oxtknight/ARTv9G1/schematics/protoboard.jpg

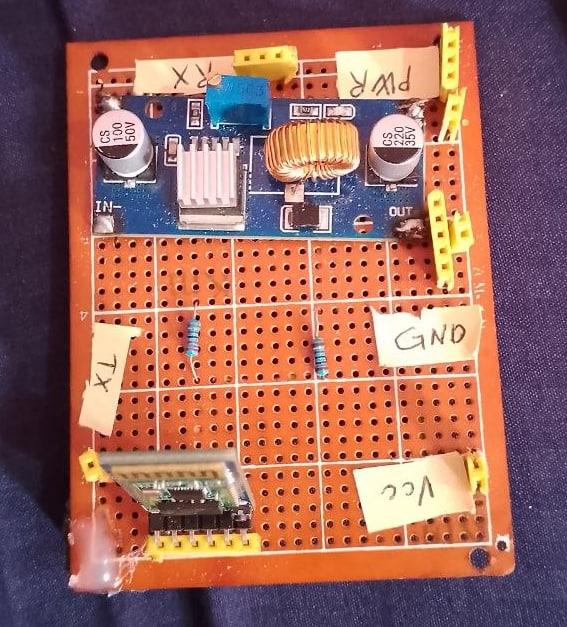
schematics/protoboard.jpg
