oxtknight/ARTv9G1/vids&pics/armbase&shoulder2.jpg

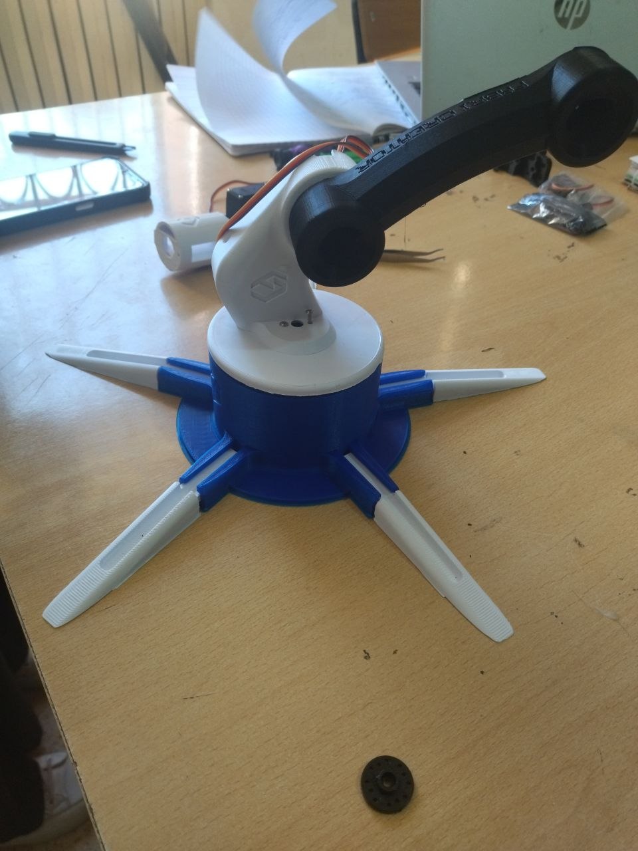
vids&pics/armbase&shoulder2.jpg
