oxtknight/ARTv9G1/schematics/note.txt

about the schematic:
Chaima said: "That's the schematic, remember that I did not find a HC05 so I used rgb"
