oxtknight/ARTv9G1/app/app_readme.md

### Some things to note:

- You can open the .aia file directly using MIT app editor or Kodular in order to make changes yourself
- You may as well install the .apk file for direct use

that's it. thank you!!
