oxtknight/ARTv9G1/app/logic blocks/arm position reset.jpg

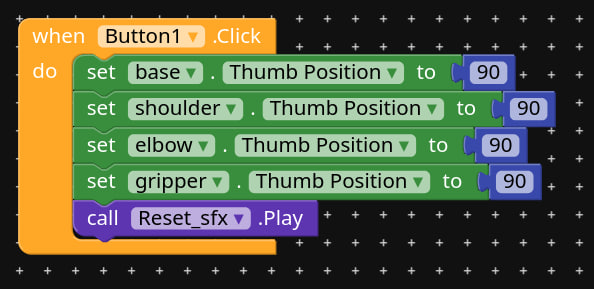
app/logic blocks/arm position reset.jpg
