oxtknight/ARTv9G1/app/logic blocks/bluetooth connection.jpg

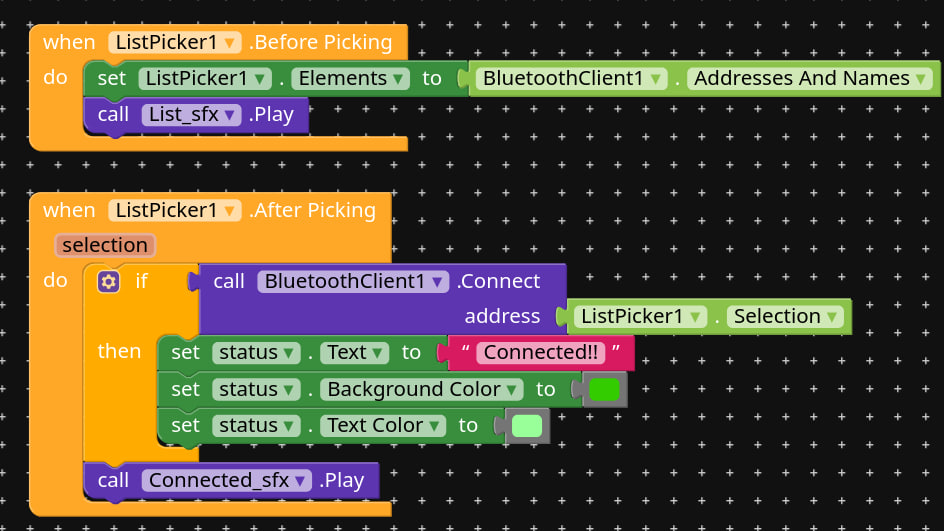
app/logic blocks/bluetooth connection.jpg
