oxtknight/ARTv9G1/app/logic blocks/inverse kin cooridinates.jpg

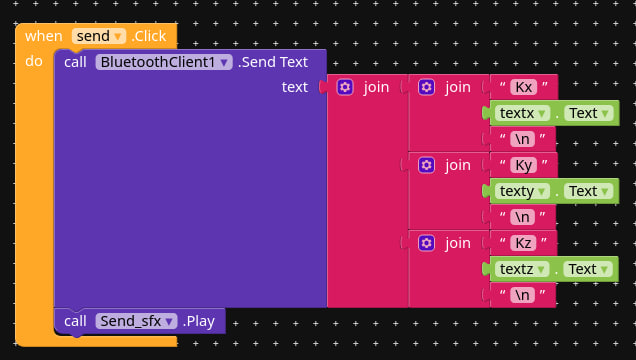
app/logic blocks/inverse kin cooridinates.jpg
