oxtknight/ARTv9G1/app/logic blocks/position_buttons.png

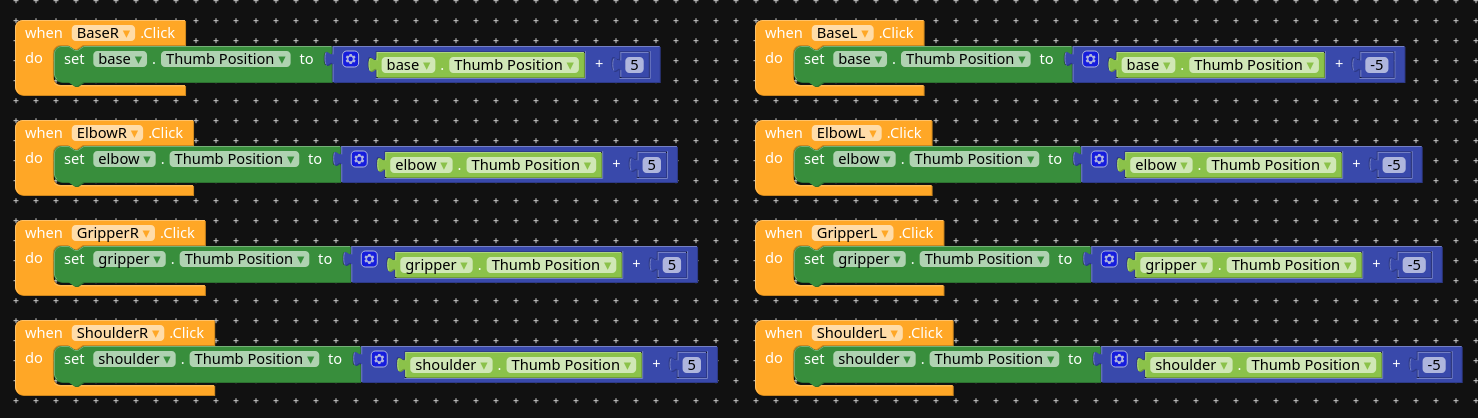
app/logic blocks/position_buttons.png
