oxtknight/ARTv9G1/app/logic blocks/position_sliders.jpg

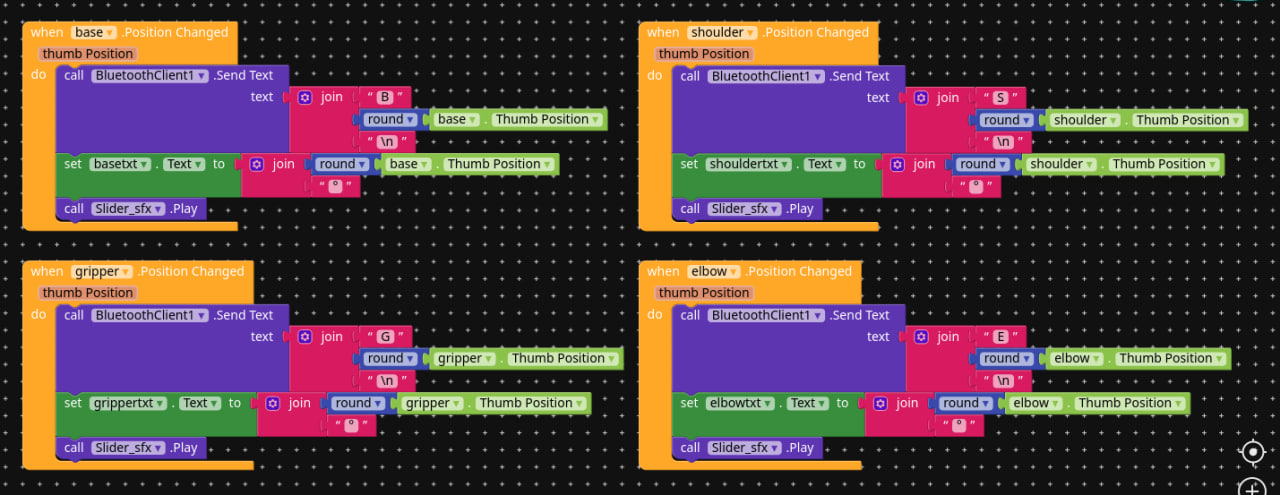
app/logic blocks/position_sliders.jpg
