oxtknight/ARTv9G1/app/User Interface.jpg

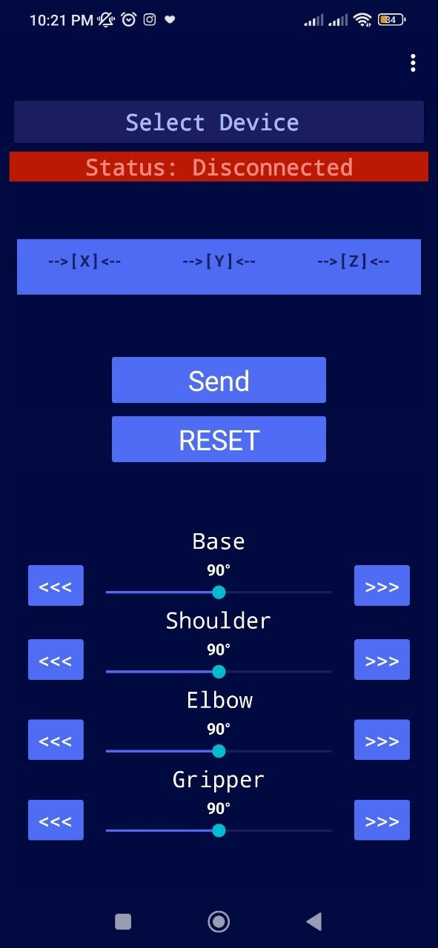
app/User Interface.jpg
