oxtknight/ARTv9G1/schematics/Screenshot from 2026-06-11 14-52-59.png

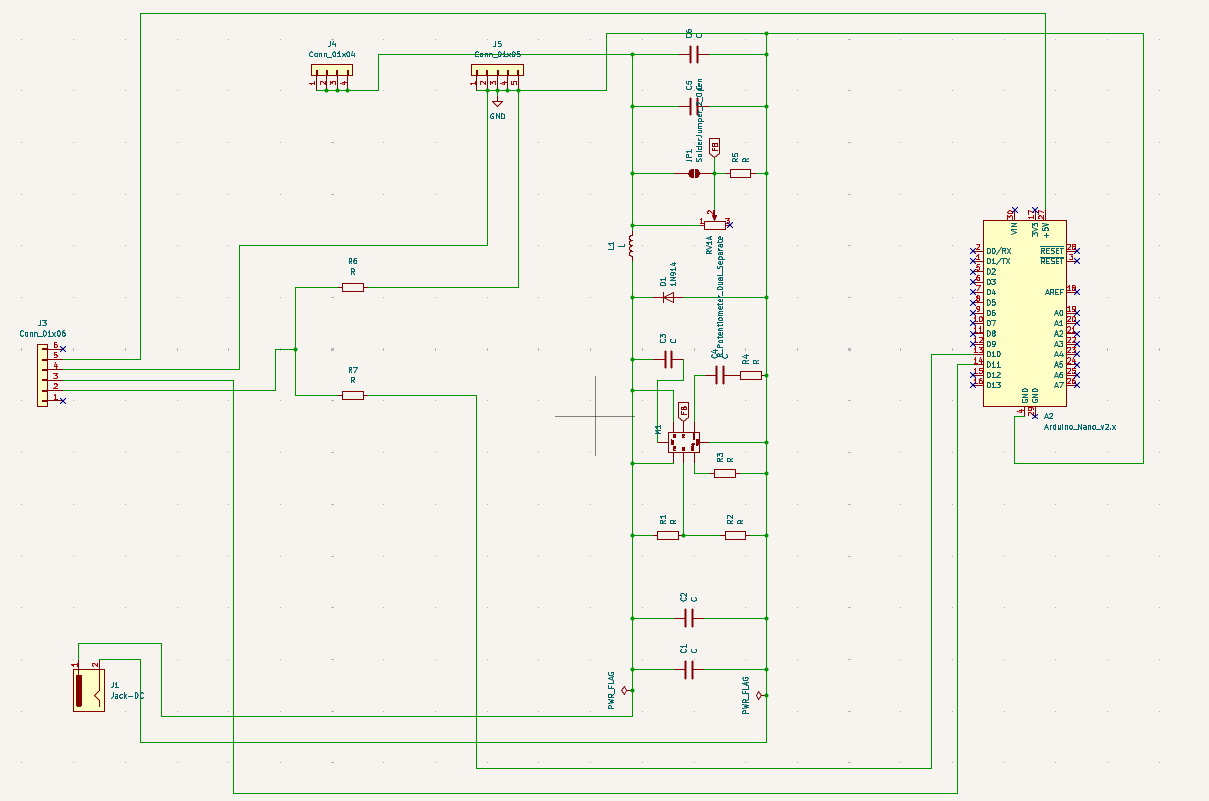
schematics/Screenshot from 2026-06-11 14-52-59.png
