oxtknight/ARTv9G1/vids&pics/aestethibasec.jpg

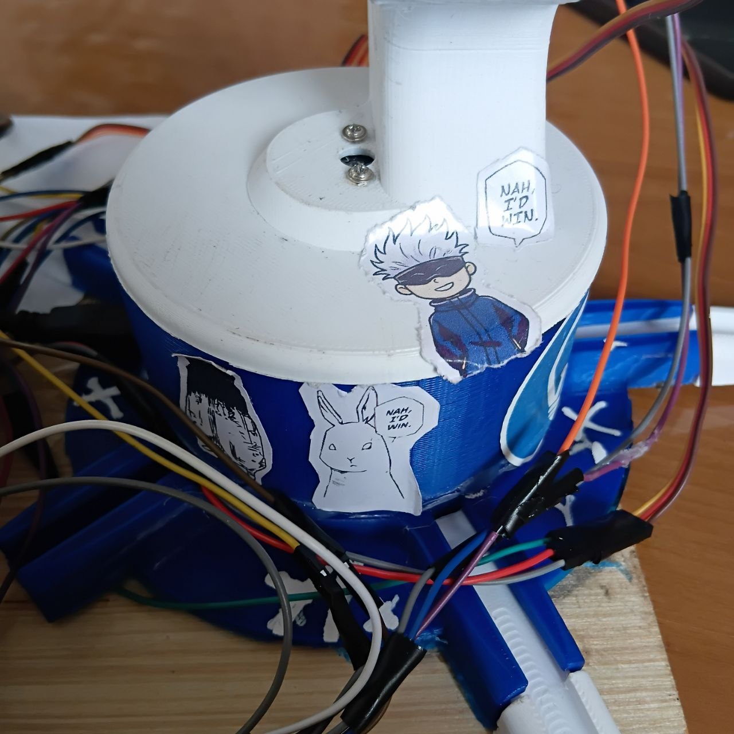
vids&pics/aestethibasec.jpg
