oxtknight/ARTv9G1/vids&pics/armbase&shoulder3.jpg

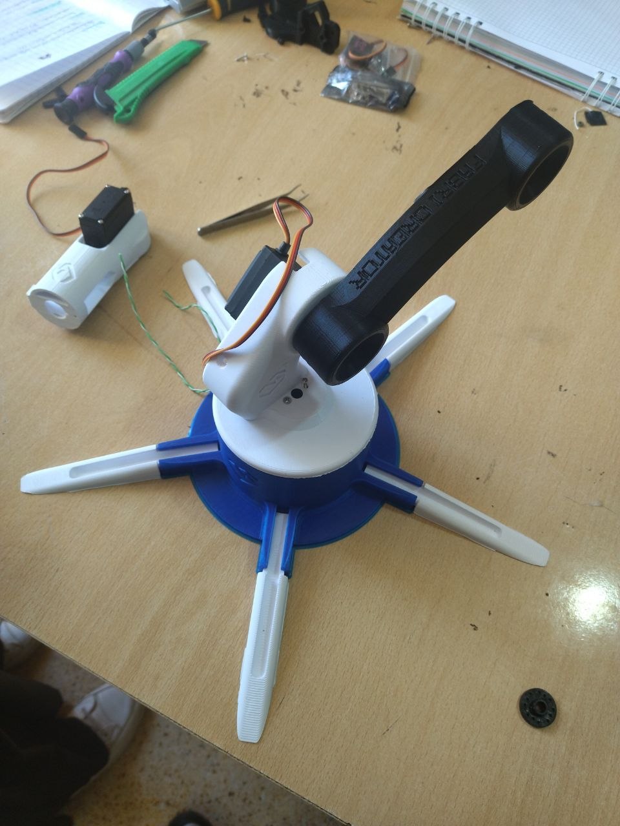
vids&pics/armbase&shoulder3.jpg
