oxtknight/ARTv9G1/vids&pics/armbase&shoulder.jpg

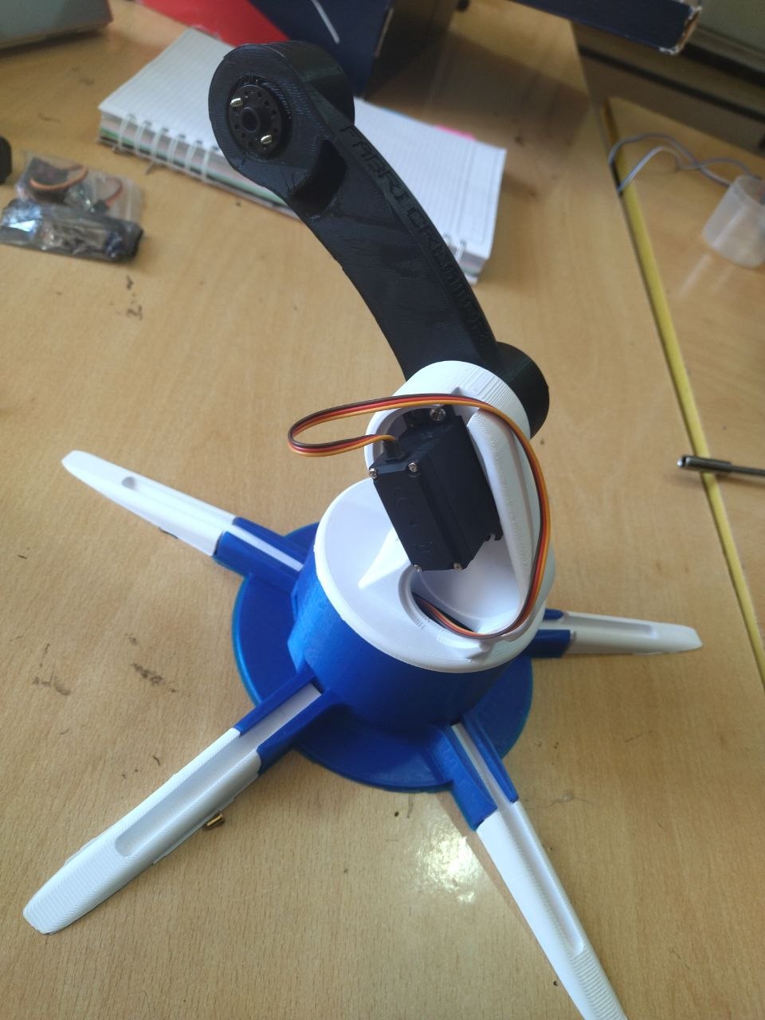
vids&pics/armbase&shoulder.jpg
