oxtknight/ARTv9G1/vids&pics/armdetached.jpg

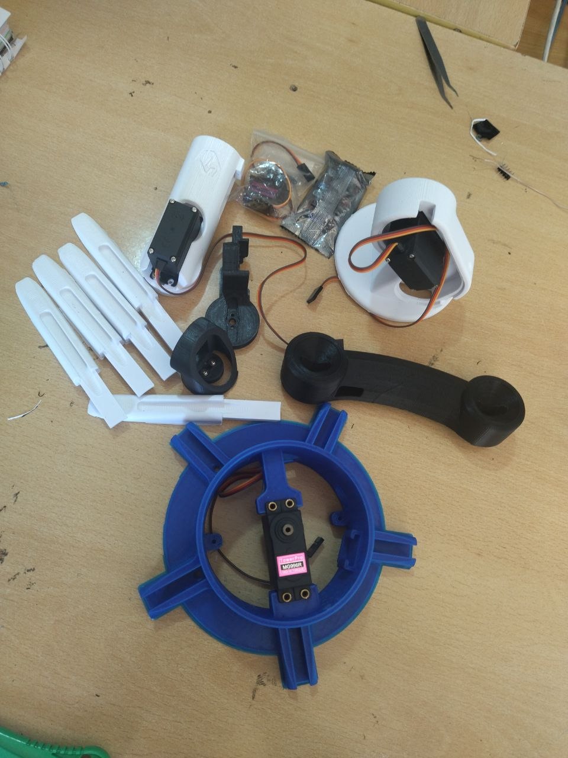
vids&pics/armdetached.jpg
