oxtknight/ARTv9G1/vids&pics/armfirstuild.jpg

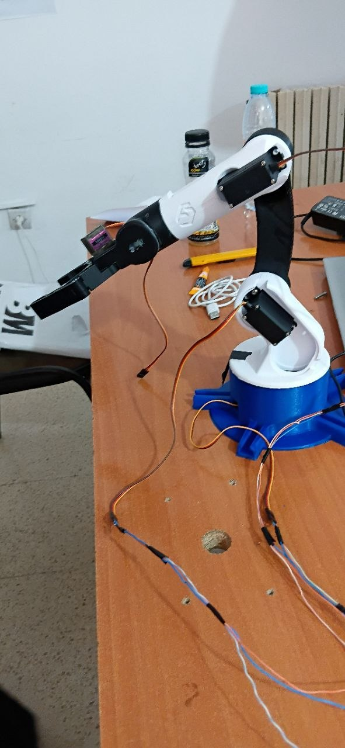
vids&pics/armfirstuild.jpg
