oxtknight/ARTv9G1/vids&pics/armrest.jpg

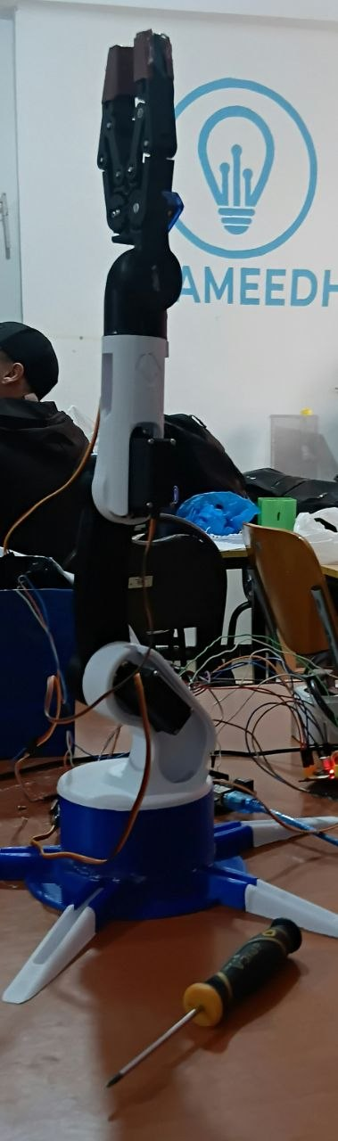
vids&pics/armrest.jpg
