oxtknight/ARTv9G1/vids&pics/hc05breadboard.jpg

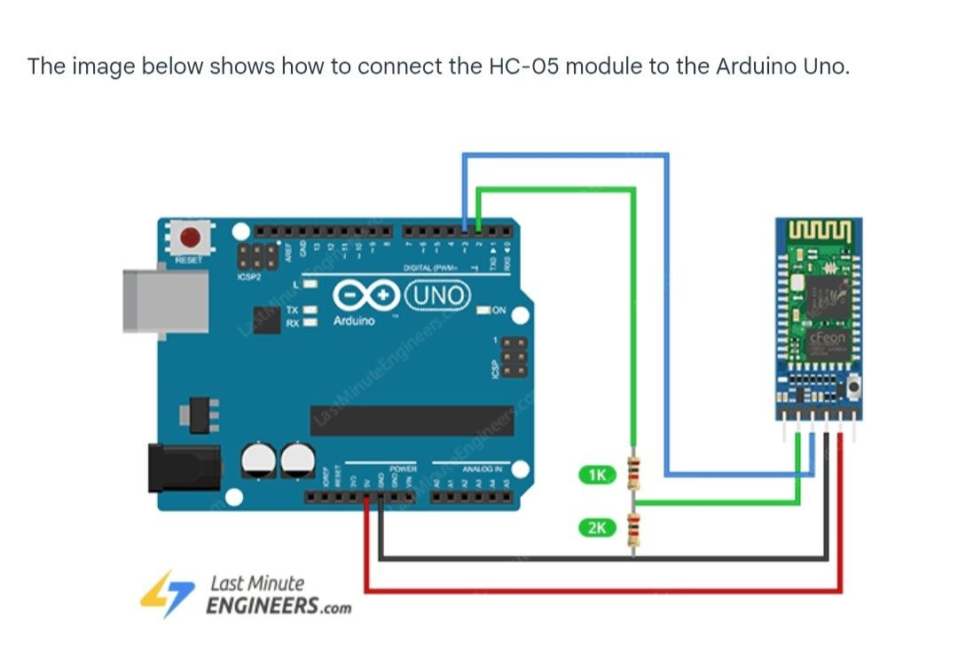
vids&pics/hc05breadboard.jpg
