oxtknight/ARTv9G1/vids&pics/hightorqueservoside.jpg

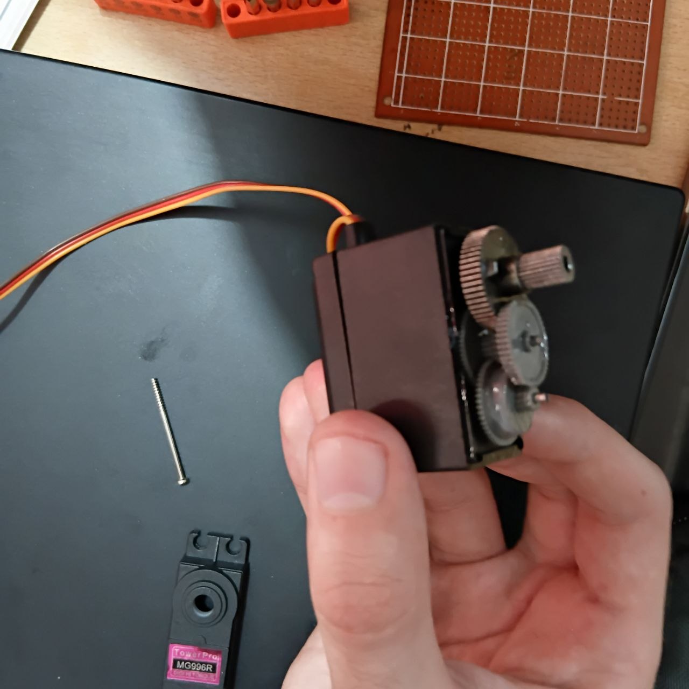
vids&pics/hightorqueservoside.jpg
