oxtknight/ARTv9G1/vids&pics/hightorqueservotop.jpg

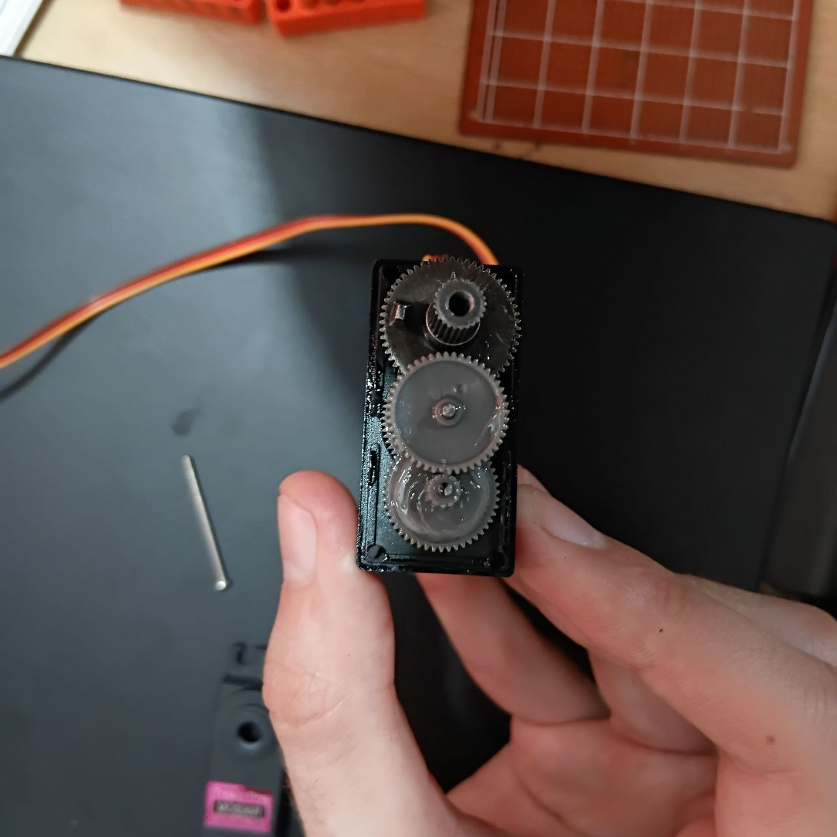
vids&pics/hightorqueservotop.jpg
