oxtknight/ARTv9G1/schematics/The Final Project.pdf

A

1 | 2 | 3 | 4 | 5 | 6

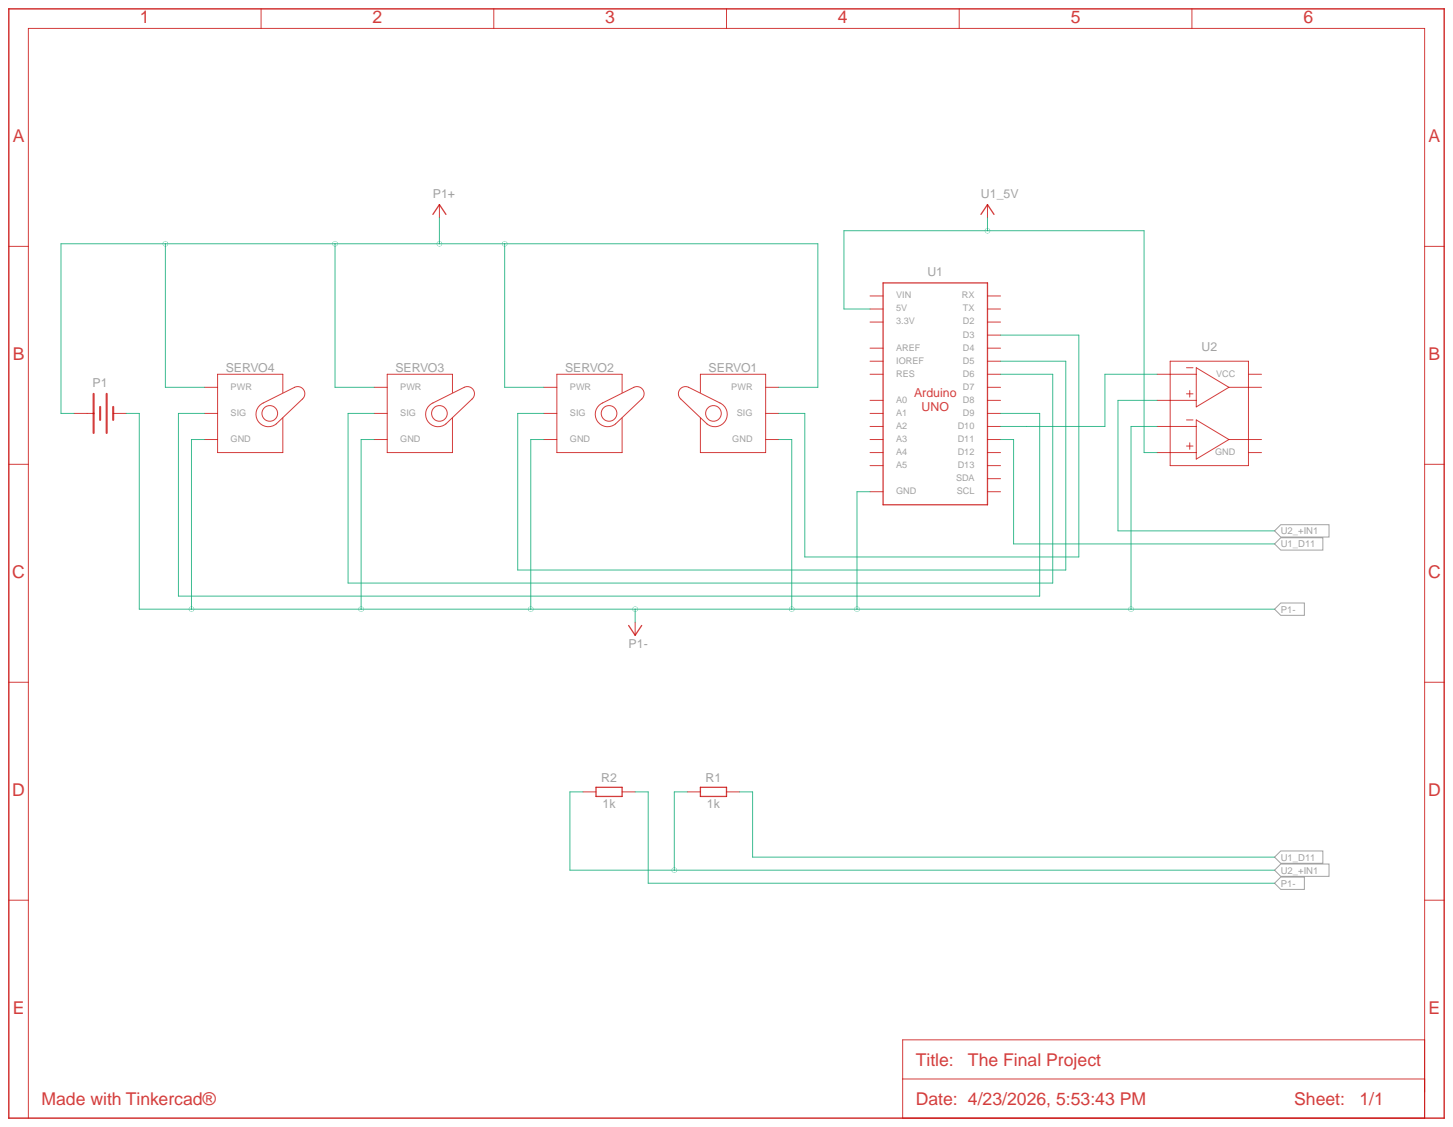
[picture p21: page 1]

Title: The Final Project
