oxtknight/ARTv9G1/(commit log)

2026-04-15 added arm.ino
2026-04-22 added the struct millis version
2026-04-23 added schematic, pics & vids
2026-04-23 replaced schematic
2026-04-25 pics and vids of arm (Rayan included)
2026-04-29 i fixed it frfr
    [robotic_arm_app.ino, robotic_arm_serial.ino]
2026-04-30 Tried an idea for servo easing, let's see if it works!
2026-05-01 Revert "Tried an idea for servo easing, let's see if it works!"
    [robotic_arm_serial_smoothtest.ino]
2026-05-01 Updated app, added buttons for more precise servo control, as well as an experimental movement code
2026-05-02 added a fix for jittering -rei
    [robotic_arm_app.ino]
2026-05-02 Tweaked app slightly, made buttons increment by 5 instead of 1
2026-06-11 Add files via upload
    the pictures in the files shows the design of the protoboard using Kicad software
    (note that the type of the back converter in this file schematics is not the same as the back converter used in the picture of the protoboard but has similar function)
